Kaitokangurei/NEW_HALF_Micromouse/docs/center-of-gravity-a04.md

# A04の重心調査

追記：[各グループ5 gというユーザー指定での概算](center-of-gravity-5g.md)を作成した。以下の実測値・材質設定の調査結果とは分けて扱う。

## 結論

**現時点では完成機の重心座標を確定できない。** A04の配置は分かるが、部品質量・部品内部の質量分布が未入力で、未設計の部品もある。
元STEPの材質設定を調べたところ、明らかに実物の質量計算に適さない設定が見つかったため、その密度から合成重心を算出する方法は採用しない。
全体重心は未確定のままにし、根拠のない座標を記入しない。

## 元STEPの材質設定の問題

トラ猫STEP v36、SHA-256 `e37a94ba0502e935bd09b7f2973f216830a515db4f88e3210957fa27de5b49ad` を監査した。
材質の`PROPERTY_DEFINITION`から密度・部品への参照を追跡し、単位もkg/m³であることを確認した。

| 対象 | STEP設定 | 問題 |
|---|---|---|
| メイン基板 | 鋼、7850 kg/m³ | 実装基板の複合材料を表していない |
| ミニッツタイヤ | 鋼、7850 kg/m³ | タイヤの材料を表していない |
| 電池 | 鋼、7850 kg/m³ | 電池の実重量・内部構造を表していない |
| 非ミラー側NFP-D0812 | アルミニウム、2700 kg/m³ | モータ全体を単一材質と見なしている |
| ミラー側NFP-D0812 | 鋼、7850 kg/m³ | 同型・同体積の反対側モータと密度が約2.91倍違う |

両モータのモデル体積は同じ約649.308 mm³。
設定どおりに換算すると約1.75 gと5.10 gになり、架空の左右重量差を作る。これは実重量ではなく、不適切な設定を示す例。
また、新しい実装基板、ファンケース、配線・固定具・センサ等の質量は揃っていない。

[監査結果JSON](../mechanical/mass-properties-audit.json)に材質設定と図心を保存した。元STEPの設定は変更していない。

## 配置から分かること

単位mm。前端Y=0、左右中心X=0、床Z=0。車軸Y=33。
以下のCAD値は**一様密度を仮定した体積図心**であり、実部品の重心ではない。
材質が異なるモータ内部・実装部品などを含めると変わる。

| 部品・形状 | X | Y | Z | 車軸に対する前後位置 |
|---|---:|---:|---:|---:|
| 左右駆動モータの体積図心 | ±6.516 | 40.830 | 7.685 | 約7.83後方 |
| ファンモータの体積図心 | 約0 | 16.500 | 13.831 | 約16.5前方 |
| ファンマウントの体積図心 | 約0 | 16.500 | 9.436 | 約16.5前方 |
| STEP羽根形状の体積図心 | 約0 | 16.500 | 5.541 | 約16.5前方 |
| 電池2本の配置中心 | ±6.3 | 33.000 | 16.500 | 車軸上。均一な直方体・左右同質量を仮定 |
| 新規基板形状の体積図心 | 約0 | 32.974 | 2.087 | 約0.026前方。未実装・穴付き基板形状のみ |

左右部品の質量と質量分布が対称なら左右重心Xは約0となるが、現在それを実測して確認したわけではない。
電池を車軸上に置くことで、電池自身の前後モーメントを抑える方針になっている。
ただし、モータ・吸引部・その他の部品によるモーメントが相殺される保証はない。

## 前後バランスの条件

体積図心が実際の各部品重心に近いと**仮定する簡略モデル**では、
左右駆動モータの合計質量をD、ファンモータ・羽根・マウントの合計質量をFとすると、
この2グループの前後モーメントはおおよそ `7.83 D − 16.5 F` [g·mm]。

- D/F ≈ 2.11なら、この2グループだけの前後モーメントは相殺する。
- D/Fが2.11より大きければ、この2グループでは後方寄り。
- D/Fが2.11より小さければ、この2グループでは前方寄り。

この比較には車輪・ギア・マウント・実装基板・センサ・ケース・配線等の残りの質量を含めていない。
この比だけで機体全体が前後どちらに重いかを断定しない。

完成機の重心は `Σ(m_i × r_i) / Σm_i`。前後オフセットはそのY座標から33を引く。
例えば**総質量が23 gだと仮定した場合**、1 gの部品を前後へ10 mm移動すると重心は約0.43 mm動く。
23 gは設計目標であり、現在の総質量を確認した値ではない。

## 実測値を反映する手順

1. [質量入力CSV](../mechanical/mass-input.csv)に各グループの質量と重心座標を入力する。電池・駆動部・吸引部を優先して測る。
2. リードやネジを含めるグループを決め、二重計上や含め忘れを防ぐ。図心で重心位置を近似する場合はnotesに「近似」と明記する。
3. 不要・別グループへ含めた行は質量0と明記する。空欄は未測定として残す。
4. リポジトリのルートで `python3 mechanical/calculate_cg.py mechanical/mass-input.csv` を実行する。

現在は未入力10グループのため、計算器は`status: incomplete`、`cg_mm: null`を返す。
未入力を0として計算することはない。全行入力後も結果の信頼性は測定・近似・網羅性に依存する。
計算器は対称配置・不等質量の解析解、未入力、明示的ゼロ、負値・非有限値の拒否を確認済み。

監査の再実行はCAD用環境で以下を実行する（実行確認は `/tmp/mouse-layout-tools` を使用）。

```sh
XDG_CACHE_HOME=/tmp/mouse-cad-cache /workspace/mouse-cad-tools/bin/python mechanical/audit_mass_properties.py /path/to/TORANEKO.Mk3_v36.step
```
