Kaitokangurei/NEW_HALF_Micromouse/mechanical/mass-scenario-5g.csv

group | mass_g | cg_x_mm | cg_y_mm | cg_z_mm | notes
left_drive | 5 | -11.545086735870335 | 36.96599326986815 | 7.220504736559388 | 仮定5g・グループ内部は一様密度の体積図心で近似
right_drive | 5 | 11.545086735828917 | 36.96599326865287 | 7.220504731455733 | 仮定5g・グループ内部は一様密度の体積図心で近似
fan_assembly | 5 | 6.012940211043943e-06 | 16.499997692316462 | 9.270365737915855 | 仮定5g・グループ内部は一様密度の体積図心で近似
battery_left | 5 | -6.3 | 33 | 16.5 | 仮定5g・直方体の一様な質量分布を仮定
battery_right | 5 | 6.3 | 33 | 16.5 | 仮定5g・直方体の一様な質量分布を仮定
