Kaitokangurei/NEW_HALF_Micromouse/docs/center-of-gravity-5g.md

# A04：各5 gを仮定した重心概算

ユーザー指定の「それぞれ5g」を、電池2本、左駆動部、右駆動部、吸引部の**5グループそれぞれ5 g**と解釈した。
実測は未実施との回答があるため、すべて仮定値。基板・配線等は別であり、これは完成機全体の重心ではない。

## 結果

| 項目 | 概算値 |
|---|---:|
| 対象5グループの質量 | 25 g |
| 左右の重心X | 約0 mm（中央） |
| 前端からの重心Y | 約31.3 mm |
| 車軸Y=33からの前後位置 | **約1.7 mm前方** |
| 床からの重心高さZ | **約11.3 mm** |

グループ内の材質分布を一様とした粗い近似であり、小数第1位の実測精度を示しているわけではない。
この仮定では主要グループだけで25 gとなり、目標23 gを超える。実物が25 gだと判明したわけではない。

## 使用したモデル

| グループ | 仮定質量 | 近似重心X | 近似重心Y | 近似重心Z |
|---|---:|---:|---:|---:|
| 左駆動部 | 5 g | -11.545 | 36.966 | 7.221 |
| 右駆動部 | 5 g | 11.545 | 36.966 | 7.221 |
| 吸引部 | 5 g | 約0 | 16.500 | 9.270 |
| 左電池 | 5 g | -6.300 | 33.000 | 16.500 |
| 右電池 | 5 g | 6.300 | 33.000 | 16.500 |

単位mm。X=0は左右中心、Y=0は機体前端、Z=0は床。
駆動部はモータ単体ではなく、車輪・ギア・軸受・マウント・磁石・エンコーダを含むグループ。
吸引部はCADに形状のあるモータ・マウント・羽根の3部品。未設計ケース等は含めない。

各グループの位置はA04のものを使用し、グループ内の形状体積の一次モーメントを足して図心を求めた。
元STEPに設定された鋼・アルミ等の不適切な密度値は使わず、そのグループ全体の質量を5 gに正規化している。
部品ごとの材質差・内部構造・空洞のモデル化精度・部品同士の重なりはこの近似の誤差要因となる。

元STEPで不正な軸受保持器2形状と対応する反対側の2形状は、左右対称に図心計算から除外した。
保持器が0 gという意味ではなく、駆動部全体の仮定5 gを残りの30形状/側へ配分する近似。
電池は直方体内で質量が均等とした。実際の電極・端子・リードの偏りは含めない。

## 前後バランスの調整量

このモデルの車軸周りの質量モーメントは約-42.84 g·mm（前方寄り）。
電池2本の合計10 gを後方へ `42.84 / 10 ≈ 4.28 mm` 移すと、計算上Y重心が33 mmとなる。
つまり電池の中心Yは約37.3 mmが目安になる。

**電池位置はまだ変更していない。** これは主要5グループだけの計算上の調整量。
基板・部品実装・センサ・スカート・電池ホルダー・配線・固定具などを加えると必要量は変わる。
移動後の干渉や実物のバランスは別途確認する。

## データと再計算

- [仮定5 gの入力CSV](../mechanical/mass-scenario-5g.csv)
- [計算結果と部品別の図心根拠](../mechanical/cg-a04-5g.json)
- [図心近似から計算するスクリプト](../mechanical/estimate_cg_5g.py)

実測用の`mass-input.csv`は未入力のまま保持し、仮定値と混ぜていない。
CSVからの合成重心は、Python標準ライブラリのみで再計算できる。

```sh
python3 mechanical/calculate_cg.py mechanical/mass-scenario-5g.csv
```

CADから再生成する場合は、指定した参照コミットのSTEPを用意する。
今回の実行は環境に導入済みのCadQuery 2.7.0を使用した。

```sh
XDG_CACHE_HOME=/tmp/mouse-cad-cache python3 mechanical/estimate_cg_5g.py /workspace/library-files/TORANEKO.Mk3_v36.step
```

ファイルのSHA-256を照合してから計算する。別版のSTEPをそのまま入力してはならない。
