Kaitokangurei/NEW_HALF_Micromouse/mechanical/sensor-a12-top.png

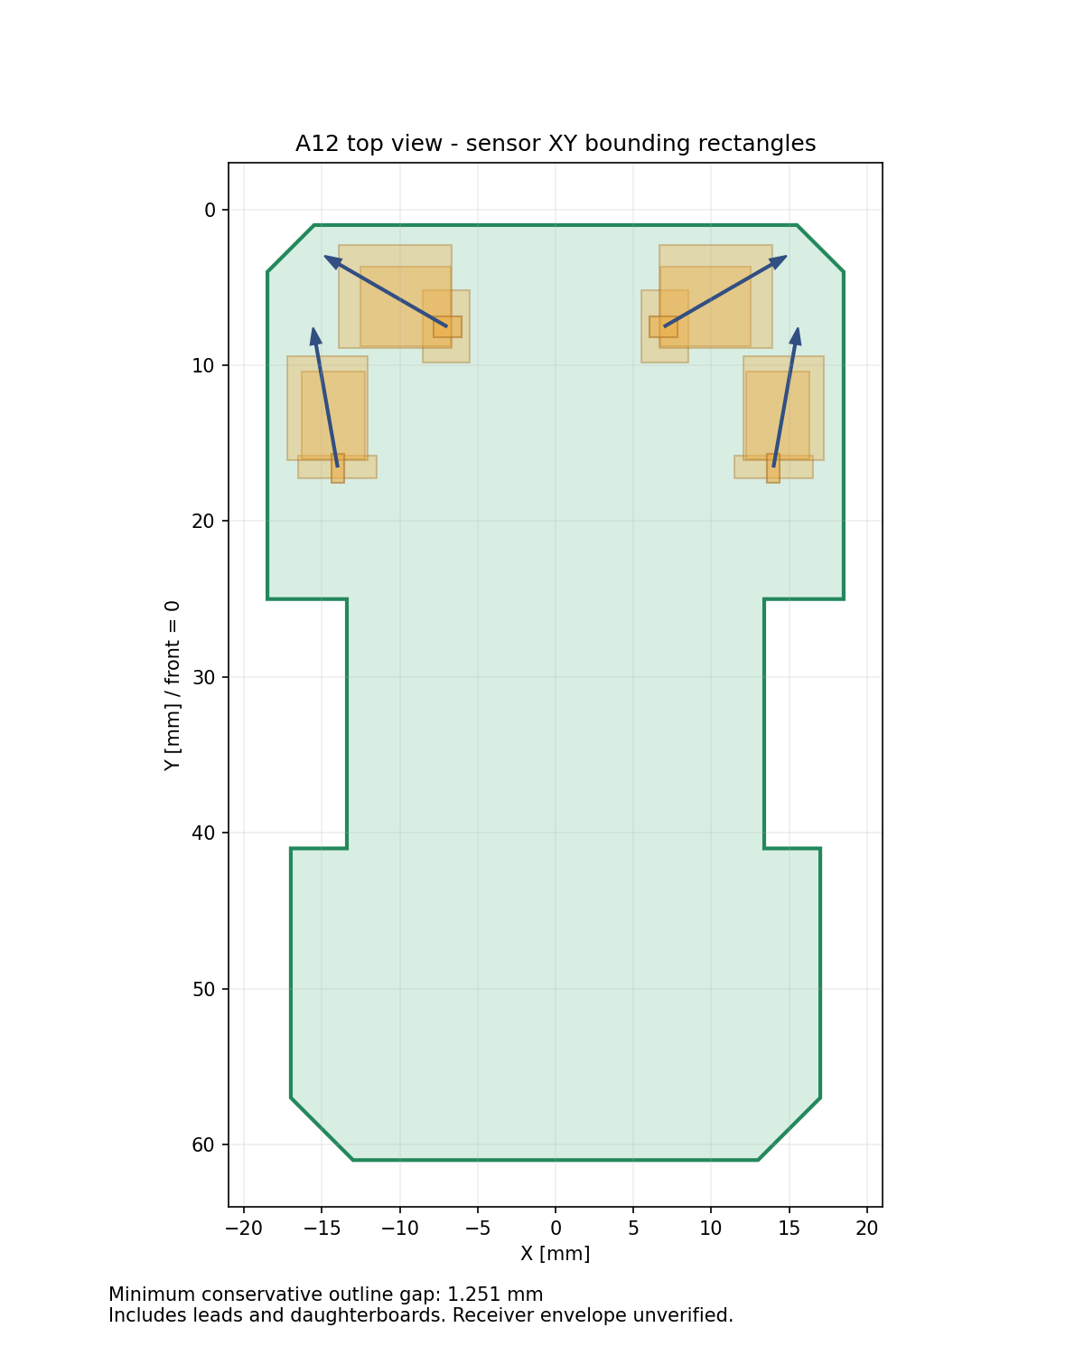
mechanical/sensor-a12-top.png
