Kaitokangurei/NEW_HALF_Micromouse/mechanical/assembly-a08.step

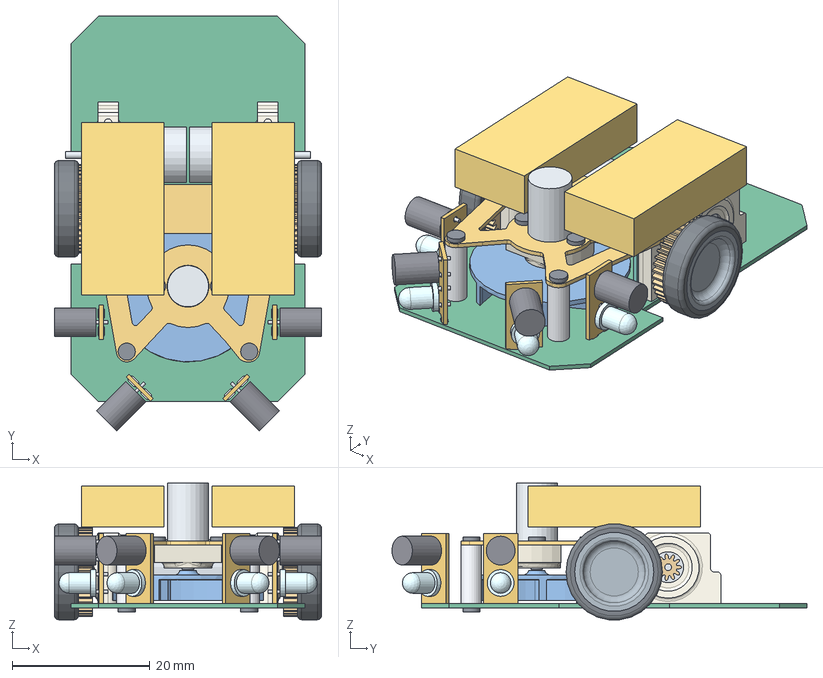
[picture p12: CAD file, 2026-10-29]
mechanical/assembly-a08.step
38.8 x 60.3 x 19.8 mm
000_motor
001_gear
002_wheel
003_tire
004_gear
005_bearing
006_bearing
007_bearing
008_bearing
009_bearing
010_bearing
011_bearing
012_bearing
013_bearing
014_bearing
015_bearing
016_bearing
017_bearing
018_bearing
019_bearing
020_bearing
021_bearing
022_bearing
023_bearing
024_bearing
025_bearing
026_magnet
027_mount
028_encoder
029_encoder
030_motor
031_gear
032_wheel
033_tire
034_gear
035_bearing
036_bearing
037_bearing
038_bearing
039_bearing
040_bearing
041_bearing
042_bearing
043_bearing
044_bearing
045_bearing
046_bearing
047_bearing
048_bearing
049_bearing
050_bearing
051_bearing
052_bearing
053_bearing
054_bearing
055_bearing
056_magnet
057_encoder
058_encoder
059_mount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
