Kaitokangurei/NEW_HALF_Micromouse/mechanical/pcb-a10-concept.step

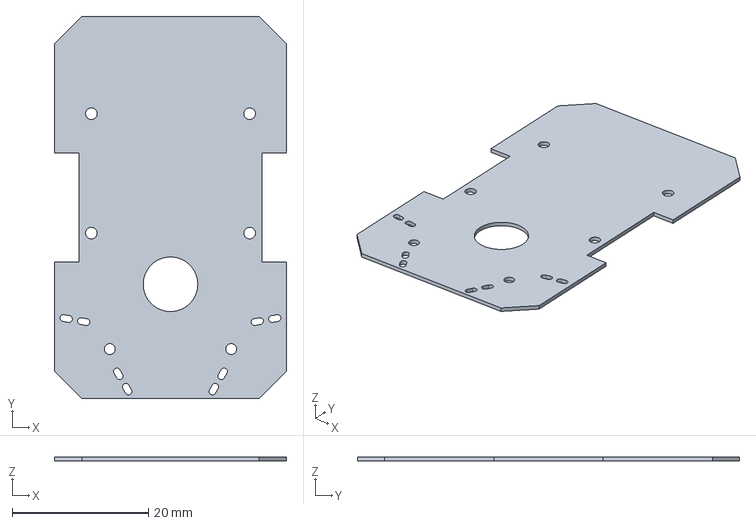
[picture p16: CAD file, 2026-10-29]
mechanical/pcb-a10-concept.step
34.0 x 56.0 x 0.6 mm
