Kaitokangurei/NEW_HALF_Micromouse/mechanical/upper-plate-a06.step

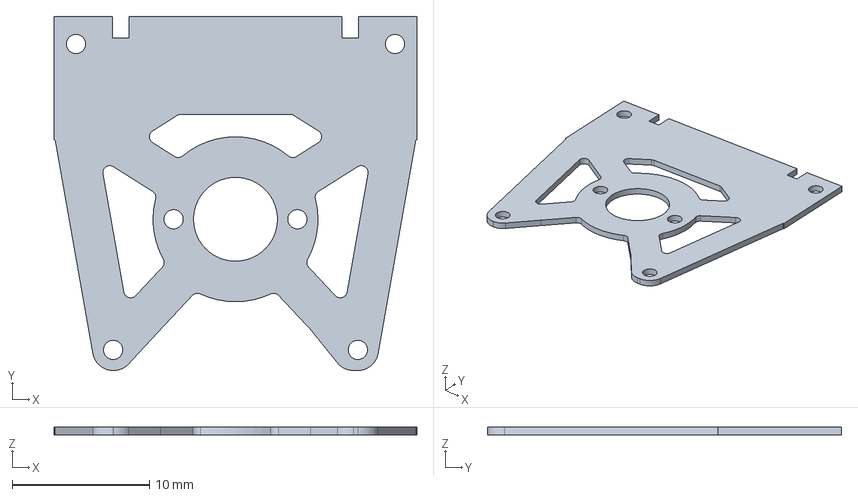
[picture p17: CAD file, 2026-10-29]
mechanical/upper-plate-a06.step
26.4 x 25.8 x 0.6 mm
