Kaitokangurei/NEW_HALF_Micromouse/mechanical/fan-bridge-a05.step

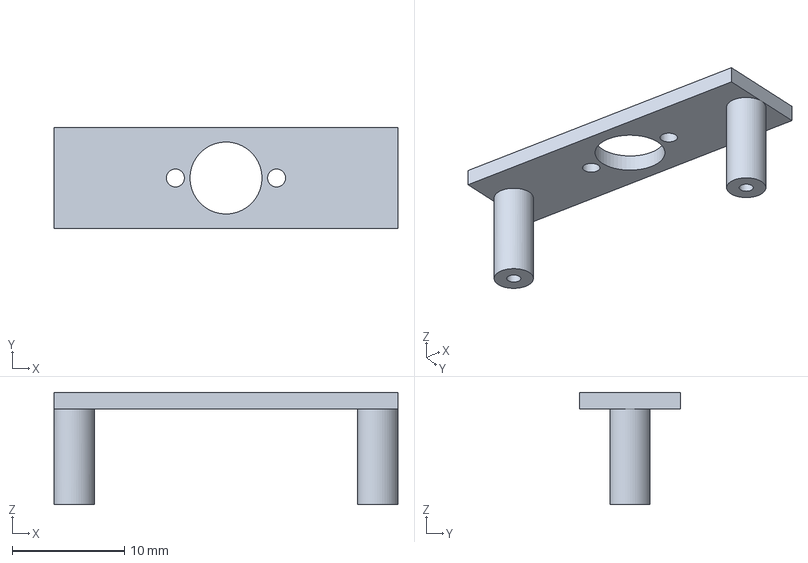
[picture p18: CAD file, 2026-10-29]
mechanical/fan-bridge-a05.step
30.6 x 9.00 x 10.0 mm
