Kaitokangurei/NEW_HALF_Micromouse/mechanical/upper-plate-a12.step

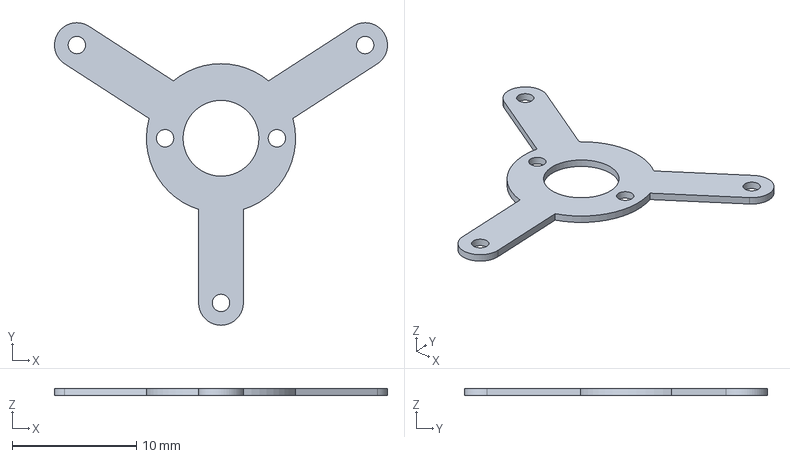
[picture p19: CAD file, 2026-10-29]
mechanical/upper-plate-a12.step
26.8 x 24.3 x 0.6 mm
