Kaitokangurei/NEW_HALF_Micromouse/mechanical/pcb-a04-concept.step

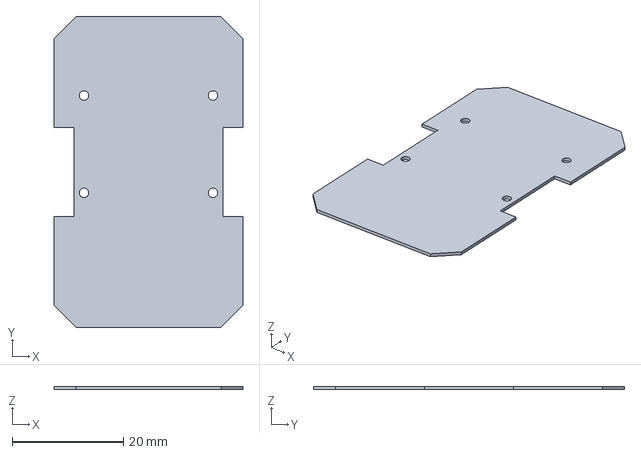
[picture p20: CAD file, 2026-10-29]
mechanical/pcb-a04-concept.step
34.0 x 56.0 x 0.6 mm
