Kaitokangurei/NEW_HALF_Micromouse/mechanical/sensor-board-a08.step

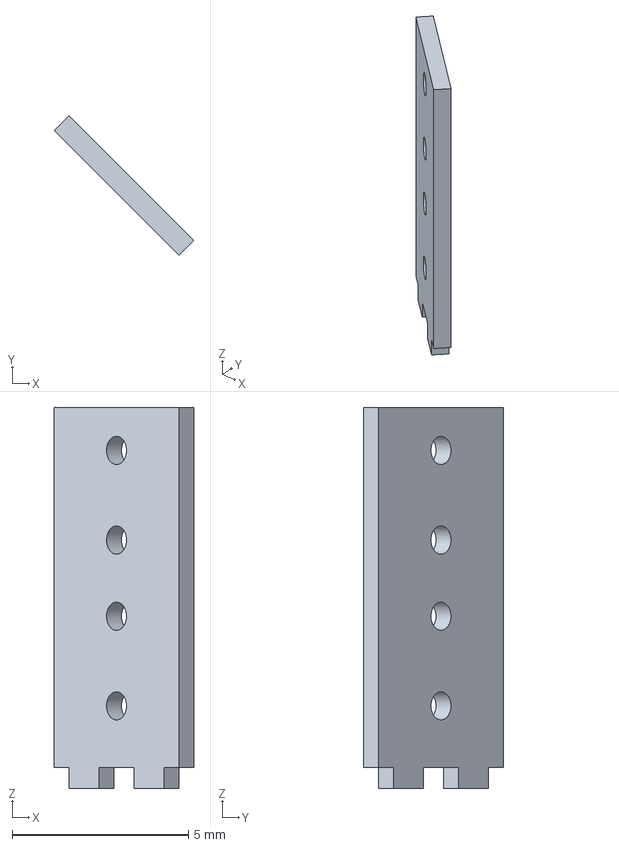
[picture p21: CAD file, 2026-10-29]
mechanical/sensor-board-a08.step
3.96 x 3.96 x 10.8 mm
