Kaitokangurei/NEW_HALF_Micromouse/mechanical/pcb-a12-concept.step

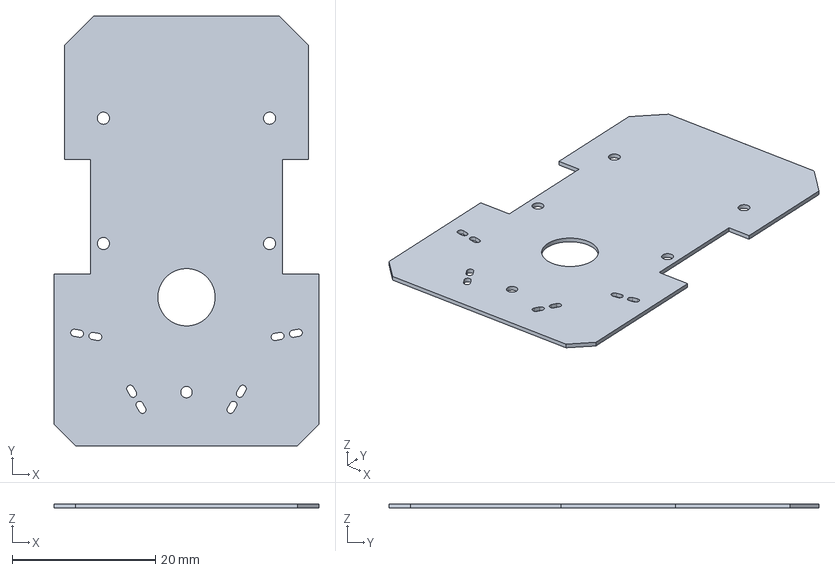
[picture p22: CAD file, 2026-10-29]
mechanical/pcb-a12-concept.step
37.0 x 60.0 x 0.6 mm
