Kaitokangurei/NEW_HALF_Micromouse/mechanical/upper-plate-a07.step

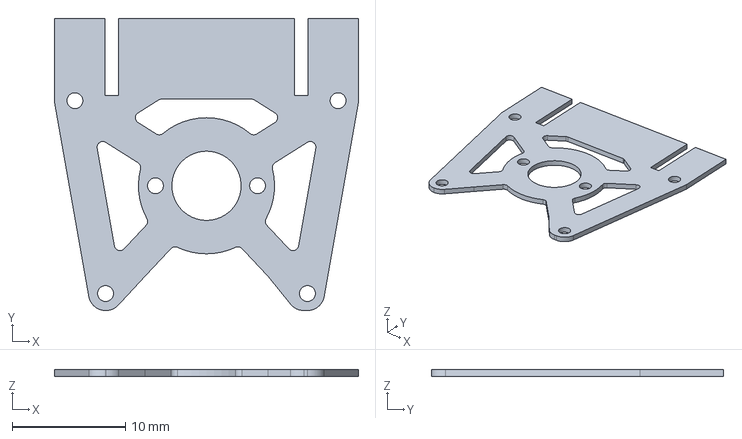
[picture p23: CAD file, 2026-10-29]
mechanical/upper-plate-a07.step
26.8 x 25.8 x 0.6 mm
