Kaitokangurei/NEW_HALF_Micromouse/mechanical/sensor-board-a09.step

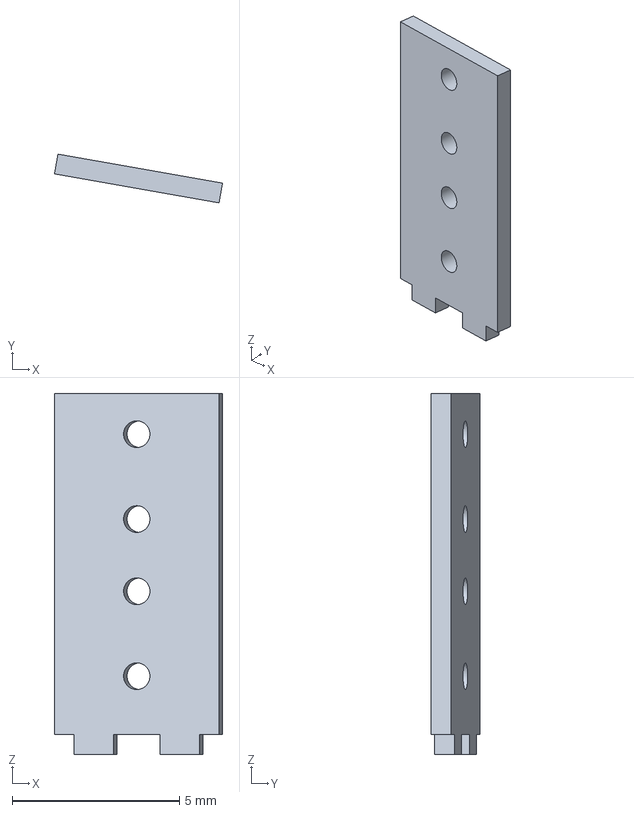
[picture p24: CAD file, 2026-10-29]
mechanical/sensor-board-a09.step
5.03 x 1.46 x 10.8 mm
