Kaitokangurei/NEW_HALF_Micromouse/mechanical/sensor-board-a10.step

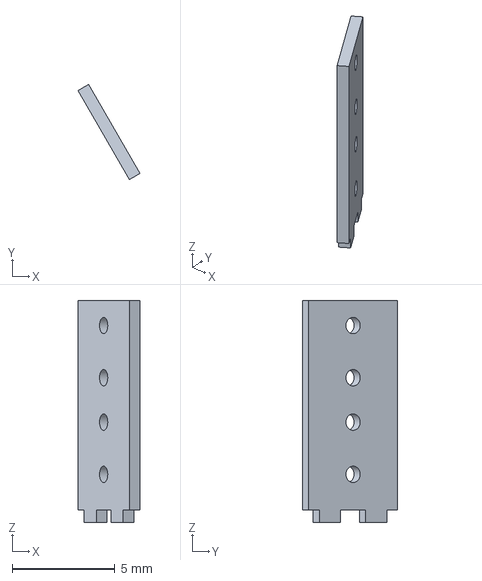
[picture p25: CAD file, 2026-10-29]
mechanical/sensor-board-a10.step
3.02 x 4.63 x 10.8 mm
