Kaitokangurei/NEW_HALF_Micromouse/(list of files, cad)

Other CAD files:
mechanical/assembly-a05.step
mechanical/assembly-a12.step
mechanical/assembly-a06.step
mechanical/pcb-a09-concept.step
mechanical/pcb-a11-concept.step
mechanical/pcb-a06-concept.step
mechanical/pcb-a07-concept.step
mechanical/pcb-a08-concept.step
mechanical/pcb-a03-concept.step
mechanical/pcb-a05-concept.step
mechanical/upper-plate-a11.step
mechanical/sensor-board-a12.step
mechanical/sensor-board-a11.step
mechanical/fan-bridge-a05.stl
mechanical/pcb-a03-concept.stl
mechanical/pcb-a04-concept.stl
