Kaitokangurei/NEW_HALF_Micromouse/mechanical/requirements-assembly.txt

cadquery==2.7.0
matplotlib==3.10.8
plotly==6.3.1
